haXoru5/GNSS_Workshop/Resources/IEEE_block.jpg

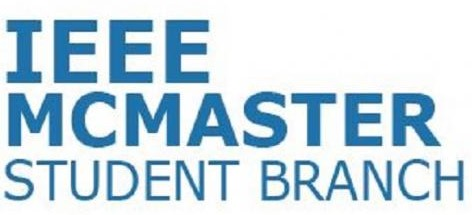
Resources/IEEE_block.jpg
