haXoru5/GNSS_Workshop/README.md

# GNSS_Workshop
GNSS Front End Workshop for McMaster IEEE PES Chapter
