haXoru5/GNSS_Workshop/Resources/fireball.png

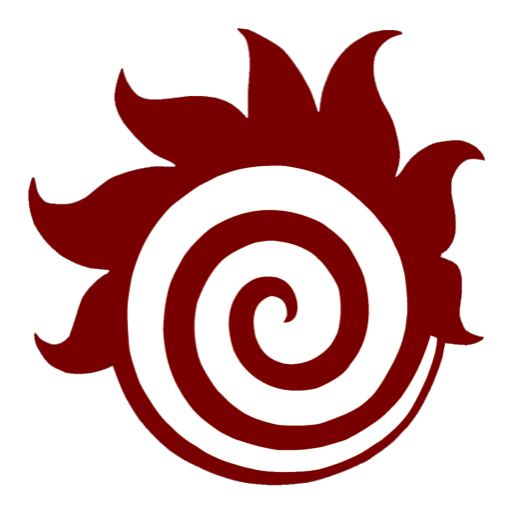
Resources/fireball.png
