haXoru5/GNSS_Workshop/Resources/IEEE_PES_block.png

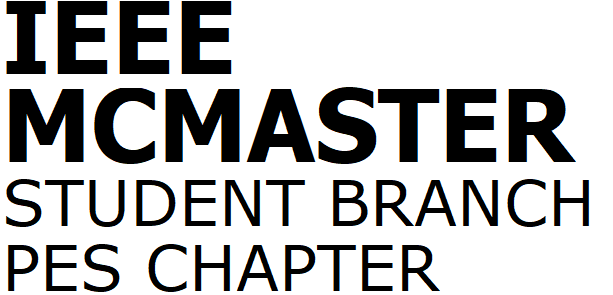
Resources/IEEE_PES_block.png
