haXoru5/GNSS_Workshop/BOMs/GNSS_FE.xlsx

Comment | Description | Designator | Footprint | Quantity | Fitted
ANT-GNSSCP-TH18L1 | CERAMIC PATCH GNSS ANTENNA | ANT1 | ANT-GNSSCP-TH18L1 | 1 | Fitted
GRM1555C1H102JA01D | CAP CER 1000PF 50V C0G/NP0 0402 | C1, C2, C3 | 0402_CAP | 0 | Not Fitted
GRM1555C1H182JA01D | CAP CER 1800PF 50V C0G/NP0 0402 | C4 | 0402_CAP | 1 | Fitted
GJM1555C1H8R1BB01D | CAP CER 8.1PF 50V C0G/NP0 0402 | C5 | 0402_CAP | 1 | Fitted
GJM1555C1H470FB01D | CAP CER 47PF 50V C0G/NP0 0402 | C6 | 0402_CAP | 1 | Fitted
GJM1555C1H1R5WB01D | CAP CER 1.5PF 50V C0G/NP0 0402 | C7 | 0402_CAP | 1 | Fitted
GCM188L81H104KA57D | CAP CER 0.1UF 50V X8L 0603 | C8 | CAP_MURATA_0603 | 1 | Fitted
Red, 2V, 140° | WL-SMCW Mono-color Chip LED Waterclear, SMT, size 0603, Red, 2V, 140° | D1 | WL-SMCW | 1 | Fitted
MM8030-2610RJ3 | SWG Connector Receptacle, Female Socket 50Ohm Surface Mount Solder | J1, J2, J3 | MURATA_MM8030-2610RJ3 | 3 | Fitted
CON-SMA-EDGE-S | CONN SMA JACK STR EDGE MNT | J4 | RFSOLUTIONS_CON-SMA-EDGE-S | 1 | Fitted
LQW15AN20NG8ZD | FIXED IND 20NH 800MA 0.186OHM SM | L1 | INDC1006X60N | 1 | Fitted
LQW15AN3N6C10D | FIXED IND 3.6NH 900MA 40 MOHM | L2 | INDC1006X60N | 1 | Fitted
36900000 | WE-SHC Shielding Cabinet, Clip, Tin Plated, Tape and Reel, 6.5x0.8x1.27mm | MP1, MP2, MP3, MP4 | 36900000 | 4 | Fitted
RC0402JR-070RL | RES 0 OHM JUMPER 1/16W 0402 | R1, R2, R3, R4, R5, R6, R7 | 0402_CAP | 3 | Fitted, Not Fitted
RC0402FR-0710KL | RES 10K OHM 1% 1/16W 0402 | R8 | 0402_CAP | 1 | Fitted
RC0402FR-07357RL | RES 357 OHM 1% 1/16W 0402 | R9 | RC0603JR-070RL | 1 | Fitted
RC0603FR-071KL | 1 kOhms ±1% 0.1W, 1/10W Chip Resistor 0603 (1608 Metric) Moisture Resistant Thick Film | R10 | RC0603JR-070RL | 1 | Fitted
B39162B3913U410 | FILTER SAW 1.588GHZ 6SMD | U1, U3 | B39162B3913U410 | 2 | Fitted
MAX2655EXT+T | IC AMP GPS 1.4GHZ-1.7GHZ SC70-6 | U2 | MAX2655EXT+T | 1 | Fitted
