haXoru5/GNSS_Workshop/BOMs/GNSS_FE_PROD.xlsx

Comment | Description | Designator | Footprint | Quantity | Fitted
[NO GND] ANT-GNSSCP-TH18L1 | CERAMIC PATCH GNSS ANTENNA | ANT1 | [NO GND] ANT-GNSSCP-TH18L1 | 1 | Fitted
GCM188L81H104KA57D | CAP CER 0.1UF 50V X8L 0603 | C1 | CAP_MURATA_0603 | 1 | Fitted
GRM1555C1H182JA01D | CAP CER 1800PF 50V C0G/NP0 0402 | C2 | 0402_CAP | 1 | Fitted
GJM1555C1H1R5WB01D | CAP CER 1.5PF 50V C0G/NP0 0402 | C3 | 0402_CAP | 1 | Fitted
GJM1555C1H470FB01D | CAP CER 47PF 50V C0G/NP0 0402 | C4 | 0402_CAP | 1 | Fitted
GJM1555C1H8R1BB01D | CAP CER 8.1PF 50V C0G/NP0 0402 | C5 | 0402_CAP | 1 | Fitted
Red, 2V, 140° | WL-SMCW Mono-color Chip LED Waterclear, SMT, size 0603, Red, 2V, 140° | D1 | WL-SMCW | 1 | Fitted
CON-SMA-EDGE-S | CONN SMA JACK STR EDGE MNT | J1 | RFSOLUTIONS_CON-SMA-EDGE-S | 1 | Fitted
LQG15HN5N6C02D | FIXED IND 5.6NH 600MA 0.18OHM SM | L1 | INDC1006X60N | 1 | Fitted
LQW15AN20NG8ZD | FIXED IND 20NH 800MA 0.186OHM SM | L2 | INDC1006X60N | 1 | Fitted
RC0402FR-0710KL | RES 10K OHM 1% 1/16W 0402 | R1 | 0402_CAP | 1 | Fitted
RC0402JR-070RL | RES 0 OHM JUMPER 1/16W 0402 | R2, R3, R4 | 0402_CAP | 1 | Fitted, Not Fitted
RC0402FR-07357RL | RES 357 OHM 1% 1/16W 0402 | R5 | RC0603JR-070RL | 1 | Fitted
RC0603FR-071KL | 1 kOhms ±1% 0.1W, 1/10W Chip Resistor 0603 (1608 Metric) Moisture Resistant Thick Film | R6 | RC0603JR-070RL | 1 | Fitted
B39162B3913U410 | FILTER SAW 1.588GHZ 6SMD | U1, U3 | B39162B3913U410 | 2 | Fitted
MAX2655EXT+T | IC AMP GPS 1.4GHZ-1.7GHZ SC70-6 | U2 | MAX2655EXT+T | 1 | Fitted
