haXoru5/GNSS_Workshop/BOMs/GNSS_MB.xlsx

Comment | Description | Designator | Footprint | Quantity | Fitted
GCM1885C2A470JA16D | CAP CER 47PF 100V C0G/NP0 0603 | C1, C4, C6 | CAP_MURATA_0603 | 3 | Fitted
GCM188L81H104KA57D | CAP CER 0.1UF 50V X8L 0603 | C2, C3, C7, C9 | CAP_MURATA_0603 | 4 | Fitted
GCM188R72A103KA37D | CAP CER 10000PF 100V X7R 0603 | C5 | CAP_MURATA_0603 | 1 | Fitted
GJM1555C1H8R1BB01D | CAP CER 8.1PF 50V C0G/NP0 0402 | C8 | 0402_CAP | 1 | Fitted
GRM188R61A105KA61D | CAP CER 1UF 10V X5R 0603 | C10, C11 | CAP_MURATA_0603 | 2 | Fitted
Red, 2V, 140° | WL-SMCW Mono-color Chip LED Waterclear, SMT, size 0603, Red, 2V, 140° | D1, D4 | WL-SMCW | 2 | Fitted
Green, 3.2V, 140° | WL-SMCW Mono-color Chip LED Waterclear, SMT, size 0603, Green, 3.2V, 140° | D2, D3 | WL-SMCW | 2 | Fitted
GSB1C211110DS1HR | USB2.0, Type C, Top mount, Center Height 1.78mm, Dual Row DIP | J1 | AMPHENOL_GSB1C211110DS1HR | 1 | Fitted
61300211121 | CONN HEADER VERT 2POS 2.54MM | J2, J4, J5 | 61300211121 | 1 | Fitted, Not Fitted
CON-SMA-EDGE-S | CONN SMA JACK STR EDGE MNT | J3 | RFSOLUTIONS_CON-SMA-EDGE-S | 1 | Fitted
LQW15AN20NG8ZD | FIXED IND 20NH 800MA 0.186OHM SM | L1 | INDC1006X60N | 1 | Fitted
36900000 | WE-SHC Shielding Cabinet, Clip, Tin Plated, Tape and Reel, 6.5x0.8x1.27mm | MP1, MP2, MP3, MP4 | 36900000 | 4 | Fitted
RC0603JR-070RL | Chip Resistor, 0 Ohm, +/- 5%, 0.1 W, -55 to 155 degC, 0603 (1608 Metric), RoHS, Tape and Reel | R1, R5, R7 | RC0603JR-070RL | 3 | Fitted
RC0603FR-0710KL | RES 10K OHM 1% 1/10W 0603 | R2, R9 | RC0603JR-070RL | 2 | Fitted
RC0603FR-0727RL | RES 27 OHM 1% 1/10W 0603 | R3, R6 | RC0603JR-070RL | 2 | Fitted
RC0603FR-075K1L | RES 5.1K OHM 1% 1/10W 0603 | R4, R8 | RC0603JR-070RL | 2 | Fitted
RC0603FR-071KL | 1 kOhms ±1% 0.1W, 1/10W Chip Resistor 0603 (1608 Metric) Moisture Resistant Thick Film | R10, R11, R13 | RC0603JR-070RL | 3 | Fitted
RC0603JR-072KL | 2 kOhms ±5% 0.1W, 1/10W Chip Resistor 0603 (1608 Metric) Moisture Resistant Thick Film | R12 | RC0603JR-070RL | 1 | Fitted
TEST_POINT | TEST POINT 2MM | TP1, TP2, TP3, TP4 | TEST_POINT | 0 | Not Fitted
FT230XS-R | USB FULL SPEED TO SERIAL UART IC | U1 | FT230XS-R | 1 | Fitted
MAX-M10M | GNSS LCC RX MOD, ROM, CRYSTAL | U2 | MAX-M10M | 1 | Fitted
TLV1117LV33DCYR | IC REG LINEAR 3.3V 1A SOT223-4 | U3 | TLV1117LV33DCYR | 1 | Fitted
