haXoru5/GNSS_Workshop/GNSS_MB/GNSS_MB.pdf

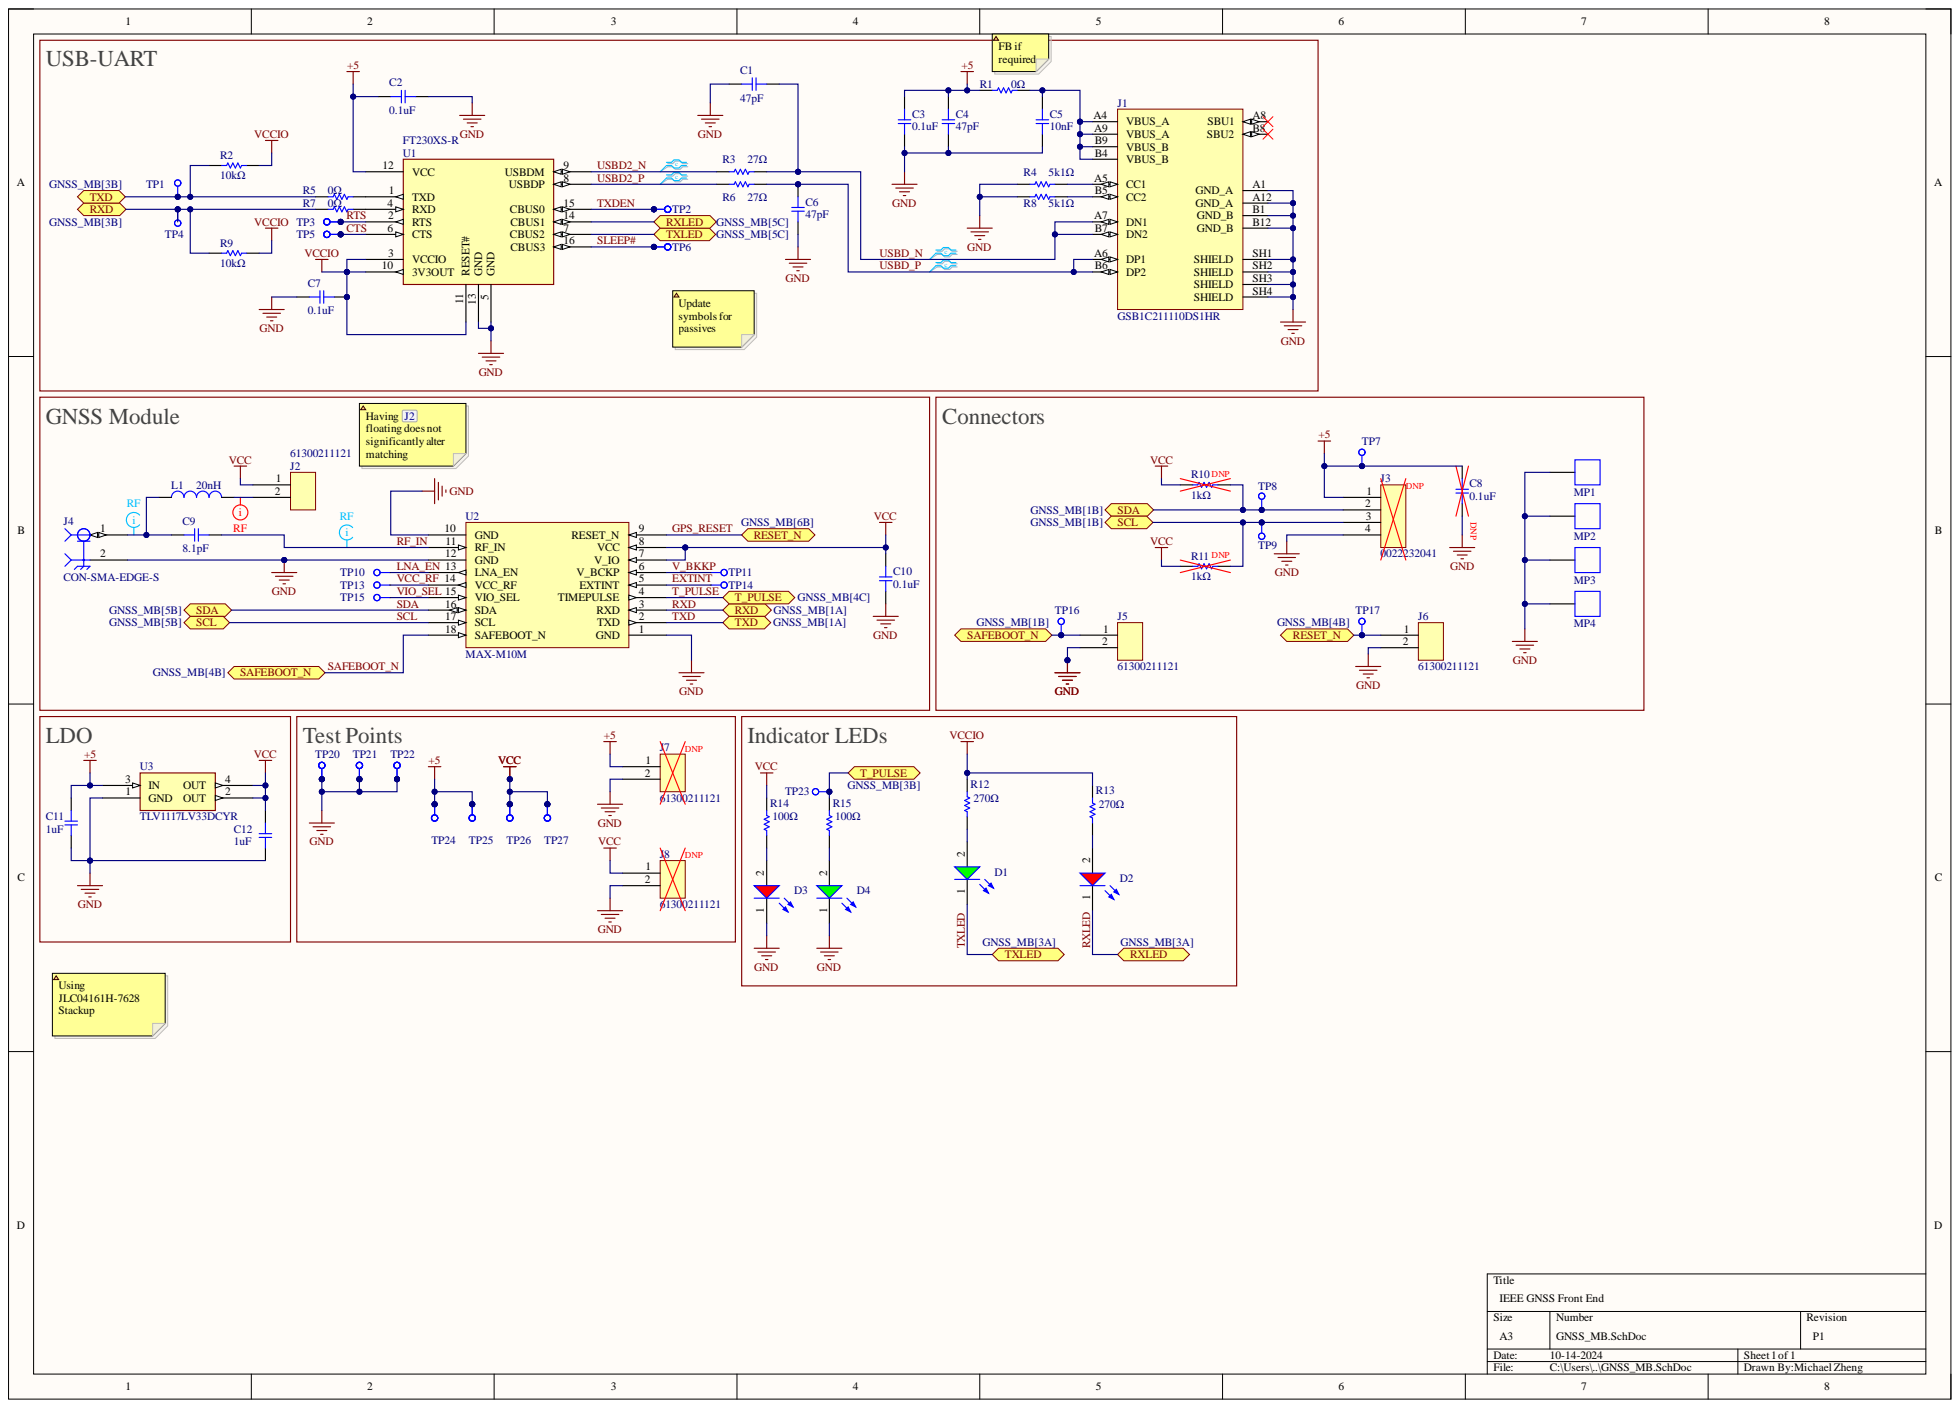
[picture p4: page 1]
