haXoru5/GNSS_Workshop/GNSS_FE/GNSS_FE.pdf

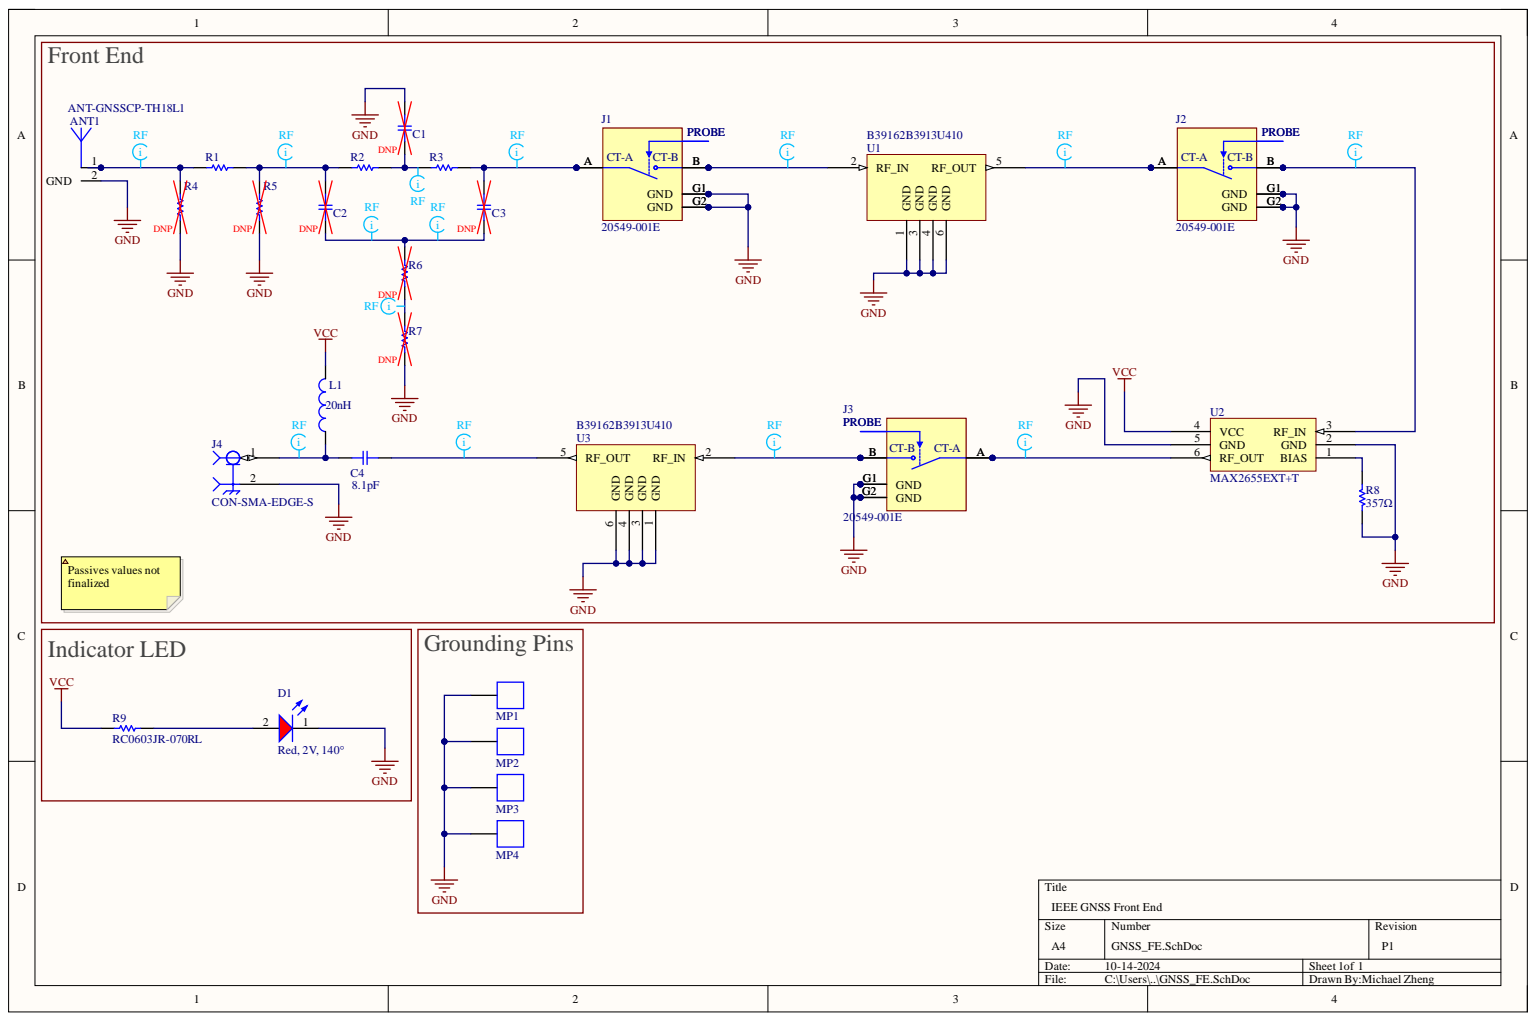
[picture p5: page 1]
