haXoru5/GNSS_Workshop/(list of files, drawings)

Other design files:
GNSS_FE/footprints.PcbLib
GNSS_FE/GNSS_FE.PcbDoc
GNSS_FE/GNSS_FE.PrjPcb
GNSS_FE/GNSS_FE.SchDoc
GNSS_FE/Symbols.SchLib
GNSS_FE_PROD/footprints.PcbLib
GNSS_FE_PROD/GNSS_FE_PROD.PcbDoc
GNSS_FE_PROD/GNSS_FE_PROD.PrjPcb
GNSS_FE_PROD/GNSS_FE_PROD.SchDoc
GNSS_FE_PROD/Symbols.SchLib
GNSS_MB/footprints.PcbLib
GNSS_MB/GNSS_MB.PcbDoc
GNSS_MB/GNSS_MB.PrjPcb
GNSS_MB/GNSS_MB.SchDoc
GNSS_MB/Symbols.SchLib
GNSS_Workshop.PrjPcb
