haXoru5/GNSS_Workshop/(threads)

Thread 1 (2024-10-03):

UART-USB chip swap

haXoru5, 2024-10-03:
Swap with smaller chip - [FT230X (ftdichip.com)](https://ftdichip.com/wp-content/uploads/2024/05/DS_FT230X.pdf)

Closed 2024-10-04.

Thread 2 (2024-10-03):

Adjust RF switches

haXoru5, 2024-10-03:
Adjust/remove switches to appropriate directions - J1 should point towards antenna, J4 should point towards M10

Likely only J1 will be kept. All others will keep footprints but will be colocated with an 0402 0ohm

Closed 2024-10-03.

Thread 3 (2024-10-03):

B13 filter

haXoru5, 2024-10-03:
Add LTE Band 13 filter right after pi network. Two options:
1) filter module - must have leads
2) Notch filter - ideally we can find already tested values

haXoru5, 2024-10-03:
For testing, how can we observe improvement for B13? Maybe we can get AWG demo unit?

haXoru5, 2024-10-03:
No appropriate filter module, will go with a notch filter, but possibly not required

haXoru5, 2024-10-04:
Added notch filter footprint in commit c848436ab70a11d6d229586d4ac44a7d858b3290

Closed 2024-10-04.

Thread 4 (2024-10-03):

Two board variant

haXoru5, 2024-10-03:
To keep within the scope of the workshop, the design will be split into two boards:
Mainboard - Power, GNSS module, UART comms
Daughterboard - RF front end, antenna

Adjustments must be made to interface between the boards
- ~~DC bias on the RF line~~
- Antenna supervisor for M10 (not critical, but good for correctness)
- ~~SMA mating between boards~~
- Mechanical support (not mandatory)
- ~~Antenna - J1 must interface with the antenna to bypass front end~~

haXoru5, 2024-10-05:
Won't do antenna supervisor. Jumper is sufficient and will not significantly affect impedance matching

Closed 2024-10-05.

Thread 5 (2024-10-03):

Shielding

haXoru5, 2024-10-03:
Shielding clips for front end https://www.we-online.com/en/components/products/WE-SHC-CLIP
Will need to determine which parts require shielding

Antenna placement
Option 1: have antenna on reverse side, will enable entire front end to be shielded
Option 2: have antenna on same side - will require via to flip everything back to front. Better visually for demonstration

Note: must leave space to connect U.FL cable

Closed 2024-10-05.

Thread 6 (2024-10-12):

P/N and Footprints for RF Caps/Ind

haXoru5, 2024-10-12:
Replace current 0603 inductors and capacitors with a standardized 0402 footprint for RF components
Find Part Numbers for non-DNP components

haXoru5, 2024-10-17:
Resolved in commit 6e51661048fd50ae1b106e603d32b9166f99046a

Closed 2024-10-17.

Thread 7 (2024-10-17):

Passives P/N

haXoru5, 2024-10-17:
Determine values/passives kits for caps/ind/fb

haXoru5, 2024-10-21:
Parts selected except for notch filter. Need to port to document from BOM

Closed 2025-02-06.

Thread 8 (2024-10-17):

DRC corrections

haXoru5, 2024-10-17:
Some footprints have internal DRC violations - ideally should be corrected before production build

haXoru5, 2024-12-09:
Resolved - adjusted constraints to match JLC specs

Closed 2024-12-09.

Thread 10 (2024-11-18):

UART Inverted

haXoru5, 2024-11-18:
UART Tx/Rx pins are inverted. Swap for V2

Closed 2024-11-18.

Thread 11 (2024-11-21):

USB-C Connection

haXoru5, 2024-11-21:
USB-C only works in one orientation. Investigate

haXoru5, 2024-12-05:
May be issue with cable, try with another one

haXoru5, 2025-02-06:
Design error unlikely, closing for now

Closed 2025-02-06.

Thread 12 (2024-12-05):

Layout v2

haXoru5, 2024-12-05:
Implement changes for V2

- LNA corrections
- IEEE Logo
- Remove some TPs (I2C, etc)
- Murata Switches
- FE Production board

haXoru5, 2024-12-09:
Final Additions added in 2e6bd027cb443b160f9abadf36882f5ce0d6c195

Closed 2024-12-09.

Thread 13 (2024-12-05):

Board Variation - Front End Production

haXoru5, 2024-12-05:
Smaller version of FE module - ideally all components can fit behind antenna
Demo unit will still be full size

haXoru5, 2024-12-09:
Added in 2e6bd027cb443b160f9abadf36882f5ce0d6c195

Closed 2024-12-09.

Thread 14 (2024-12-05):

Murata Switches

haXoru5, 2024-12-05:
Unable to source cable for existing RF switches replace with:
https://www.digikey.ca/en/products/detail/murata-electronics/MM8030-2610RJ3/3635132
https://www.digikey.ca/en/products/detail/murata-electronics/MXHQ87WA3000/3909120

Closed 2024-12-09.

Thread 15 (2024-12-19):

Shielding Vias Distance

haXoru5, 2024-12-19:
Distance between shielding vias and trace should be clearance (S) and clearance cutout should be introduced
Previously not noticed due to S and default clearance being similar

Closed 2025-02-06.

Thread 16 (2025-02-06):

LED Brightness

haXoru5, 2025-02-06:
Adjust LED brightness. Greens are significantly brighter

haXoru5, 2025-02-12:
Will order a few resistors to test, leaving unchanged for now

haXoru5, 2025-02-17:
Add some 2k, 5kohm to order

Thread 17 (2025-02-17):

Project Cleanup - v2

haXoru5, 2025-02-17:
Fix DRC solder mask sliver violations
Currently only schematic BOM is accurate - update PCB to match
