haXoru5/GNSS_Workshop/(commit log)

2024-09-26 Initial commit of footprints and schematic
    [GNSS_Workshop.PrjPcb, Sheet1.SchDoc, Symbols.SchLib, footprints.PcbLib]
2024-09-26 Added connectors and indicator LEDs
    [GNSS_Workshop.PrjPcb, Sheet1.SchDoc, Symbols.SchLib, footprints.PcbLib]
2024-09-26 Added PDF, renamed schematic
    [GNSS_Workshop.PrjPcb, GNSS_Workshop.SchDoc]
2024-09-26 Added indicator LEDs
    [GNSS_Workshop.PrjPcb, GNSS_Workshop.SchDoc, Symbols.SchLib, footprints.PcbLib]
2024-09-27 Added USB-UART IC
    [GNSS_Workshop.PrjPcb, GNSS_Workshop.SchDoc, Symbols.SchLib, footprints.PcbLib]
2024-09-27 Added fixed impedance markers
    [GNSS_Workshop.PrjPcb, GNSS_Workshop.SchDoc]
2024-09-28 Changed connector to USB-C
    [GNSS_Workshop.PrjPcb, GNSS_Workshop.SchDoc, Symbols.SchLib, footprints.PcbLib]
2024-10-03 Adjusted RF switch orientations
    [GNSS_Workshop.PrjPcb, GNSS_Workshop.SchDoc, footprints.PcbLib]
2024-10-03 Resolved issue #2
    [GNSS_Workshop.SchDoc]
2024-10-04 Added FE project folder for #4
    [GNSS_FE.PrjPcb, GNSS_FE.SchDoc, GNSS_MB.PrjPcb, GNSS_MB.SchDoc, Symbols.SchLib, footprints.PcbLib]
2024-10-04 Resolved Issue #1 and added SMA port on MB side
    [GNSS_MB.SchDoc, Symbols.SchLib, footprints.PcbLib]
2024-10-04 Resolved Issue #4 on FE side
    [GNSS_FE.PrjPcb, GNSS_FE.SchDoc, Symbols.SchLib, footprints.PcbLib]
2024-10-04 Updated PDF
    [GNSS_MB.PrjPcb, GNSS_MB.SchDoc]
2024-10-05 Resolved issue #4 on MB
    [GNSS_MB.PrjPcb, GNSS_MB.SchDoc, Symbols.SchLib, footprints.PcbLib]
2024-10-05 Resolved issue #4 on FE
    [GNSS_FE.PrjPcb, GNSS_FE.SchDoc]
2024-10-05 Resolved issue #5 on MB
    [GNSS_MB.SchDoc, Symbols.SchLib, footprints.PcbLib]
2024-10-05 Resolved issue #5 on FE
    [GNSS_FE.SchDoc, Symbols.SchLib, footprints.PcbLib]
2024-10-09 Corrected Project Names
    [GNSS_FE.PrjPcb, GNSS_FE.SchDoc, GNSS_MB.PrjPcb, GNSS_MB.SchDoc, Symbols.SchLib, footprints.PcbLib]
2024-10-12 Initial PCB Layout - MB
    [GNSS_MB.PcbDoc, GNSS_MB.PrjPcb, GNSS_MB.SchDoc, Symbols.SchLib, footprints.PcbLib]
2024-10-12 Initial PCB Layout - FE
    [GNSS_FE.PcbDoc, GNSS_FE.PrjPcb, GNSS_FE.SchDoc]
2024-10-14 Initial commit of FE PCB
    [GNSS_FE.PcbDoc, GNSS_FE.PrjPcb, GNSS_FE.SchDoc, Symbols.SchLib, footprints.PcbLib]
2024-10-14 Initial commit of FE PCB (auto)
2024-10-14 Initial commit of MB PCB
    [GNSS_MB.PcbDoc, GNSS_MB.PrjPcb, GNSS_MB.SchDoc, footprints.PcbLib]
2024-10-14 Added PCB PDF
    [GNSS_FE.PrjPcb]
2024-10-14 Added MB PCB PDF
2024-10-15 Modified board dimensions
    [GNSS_FE.PcbDoc]
2024-10-15 Added thermal relief on GND
    [GNSS_MB.PcbDoc]
2024-10-15 Resolved dead copper
    [GNSS_MB.PcbDoc]
2024-10-16 Corrected DRC clearance violations MB
    [GNSS_MB.PcbDoc, footprints.PcbLib]
2024-10-16 Corrected DRC clearance violations FE
    [GNSS_FE.PcbDoc]
2024-10-21 Added IEEE Logo FE
    [GNSS_FE.PcbDoc, GNSS_FE.PrjPcb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]
2024-10-21 Added IEEE Logo MB
    [GNSS_MB.PcbDoc, GNSS_MB.PrjPcb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]
2024-11-03 Project was moved to the native VCS repository (Versioned Storage) in your Altium Server. Your local project (local repository) now needs to be switched to point to this new remote repository. Please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
    [GNSS_FE.PrjPcb]
2024-11-03 initial commit altium65
    [GNSS_MB.PrjPcb]
2024-11-18 Resolved Issue #10
    [GNSS_MB.PcbDoc, GNSS_MB.PrjPcb, GNSS_MB.SchDoc]
2024-11-21 Updated passives for LNA
    [GNSS_FE.SchDoc, Symbols.SchLib, footprints.PcbLib]
2024-12-09 Resolved Issues #12 and #8
    [GNSS_MB.PcbDoc, GNSS_MB.PrjPcb, GNSS_MB.SchDoc, Symbols.SchLib, footprints.PcbLib]
2024-12-09 Added via tenting
    [GNSS_MB.PcbDoc, GNSS_MB.PrjPcb]
2024-12-09 Resolved Issues #12 and #14 for FE Demo Version
    [GNSS_FE.PcbDoc, GNSS_FE.SchDoc, GNSS_FE_PROD.PcbDoc, GNSS_MB.PrjPcb, Symbols.SchLib, footprints.PcbLib]
2024-12-09 Added IEEE Logo
    [GNSS_FE.PcbDoc]
2024-12-09 Resolved DRCs
    [GNSS_FE.PcbDoc]
2024-12-09 Removed GNSS_FE_PROD
    [GNSS_FE.PrjPcb, GNSS_FE_PROD.PcbDoc]
2024-12-09 Initial Release GNSS_FE_PROD
    [GNSS_FE_PROD.PcbDoc, GNSS_FE_PROD.PrjPcb, GNSS_FE_PROD.SchDoc, Symbols.SchLib, footprints.PcbLib]
2024-12-09 Added Logo
    [GNSS_FE_PROD.PcbDoc]
2024-12-09 Minor Fixes
    [GNSS_FE.PcbDoc, GNSS_FE.PrjPcb]
2024-12-09 Optimized Polygon pour
    [GNSS_MB.PcbDoc]
2024-12-09 Added shielding vias
    [GNSS_FE.PcbDoc]
2024-12-21 Prod Updates
    [GNSS_FE_PROD.PcbDoc, GNSS_FE_PROD.PrjPcb, GNSS_FE_PROD.SchDoc]
2025-02-06 Resolved Issue #7
    [GNSS_FE.PcbDoc, GNSS_FE.SchDoc, GNSS_FE_PROD.PcbDoc, GNSS_FE_PROD.SchDoc, GNSS_MB.PcbDoc, GNSS_MB.SchDoc]
2025-02-06 Updated Silk
    [GNSS_FE.PcbDoc, GNSS_FE_PROD.PcbDoc, GNSS_MB.PcbDoc]
2025-02-06 Resolved Issue #15
    [GNSS_FE.PcbDoc, GNSS_FE_PROD.PcbDoc, GNSS_MB.PcbDoc]
2025-02-06 Minor Via fixes
    [GNSS_FE_PROD.PrjPcb, GNSS_MB.PcbDoc]
2025-02-12 Added Thermal Relief
    [GNSS_FE.PcbDoc, GNSS_FE_PROD.PcbDoc, GNSS_MB.PcbDoc]
2025-02-17 Added BOM and Gerbers
    [GNSS_FE.xlsx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]
2025-02-19 Corrected BOM
    [GNSS_FE.PcbDoc, GNSS_FE.SchDoc, GNSS_FE.xlsx, GNSS_FE_PROD.SchDoc, GNSS_FE_PROD.xlsx, GNSS_MB.SchDoc, GNSS_MB.xlsx]
2025-02-19 BOM Corrections
    [GNSS_FE.PrjPcb, GNSS_FE.xlsx, GNSS_FE_PROD.PrjPcb, GNSS_FE_PROD.xlsx, GNSS_MB.PrjPcb, GNSS_MB.SchDoc, GNSS_MB.xlsx]
2025-02-28 Corrected L2 FE
    [GNSS_FE_PROD.PrjPcb]
